PinToCode/Smart-Table-Assistant-/assests/IMG_6858.jpg

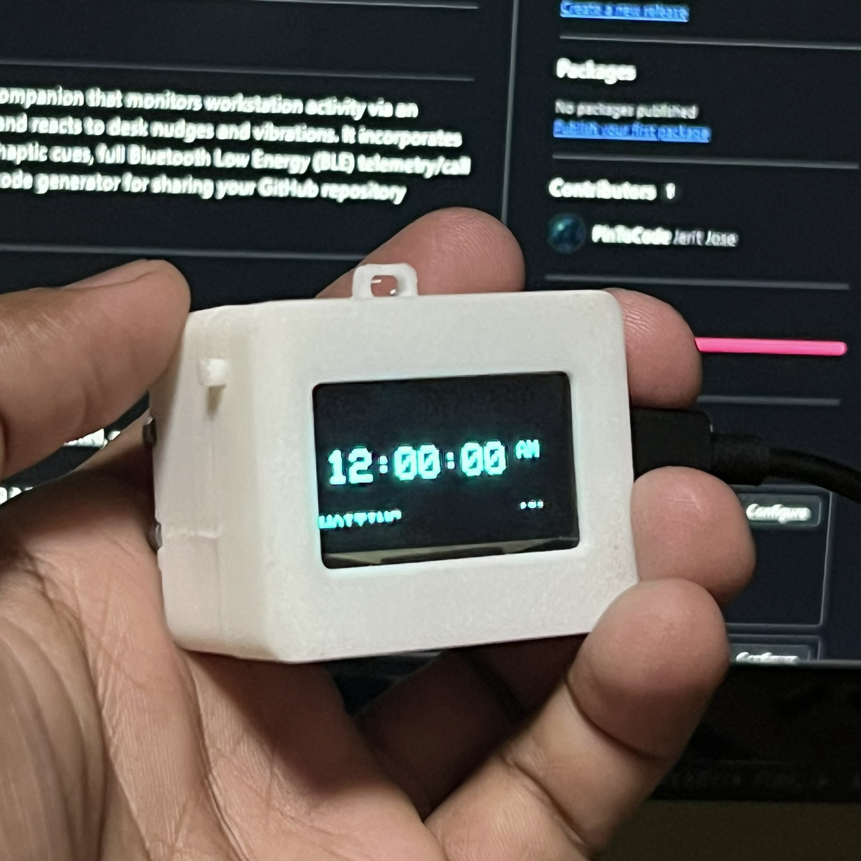
assests/IMG_6858.jpg
