PinToCode/Smart-Table-Assistant-/assests/IMG_6861.jpg

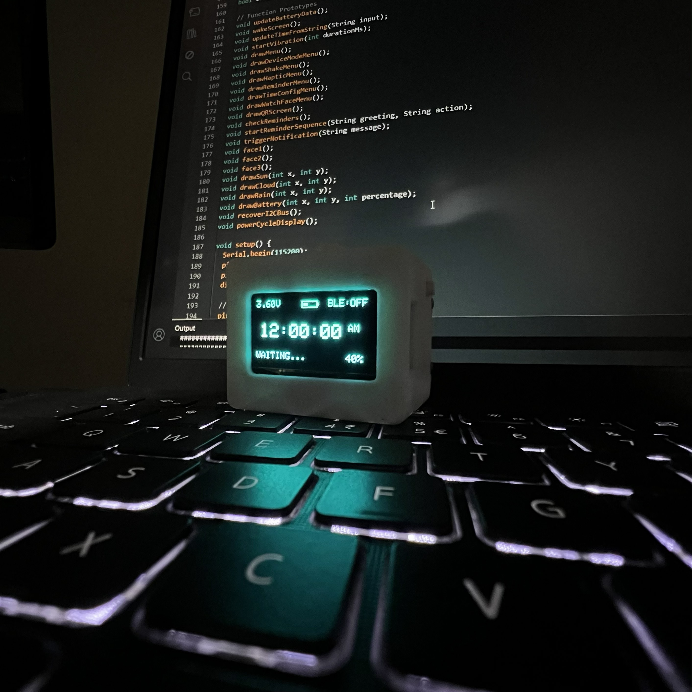
assests/IMG_6861.jpg
