PinToCode/Smart-Table-Assistant-/cad/cad files separatly/part2.stl

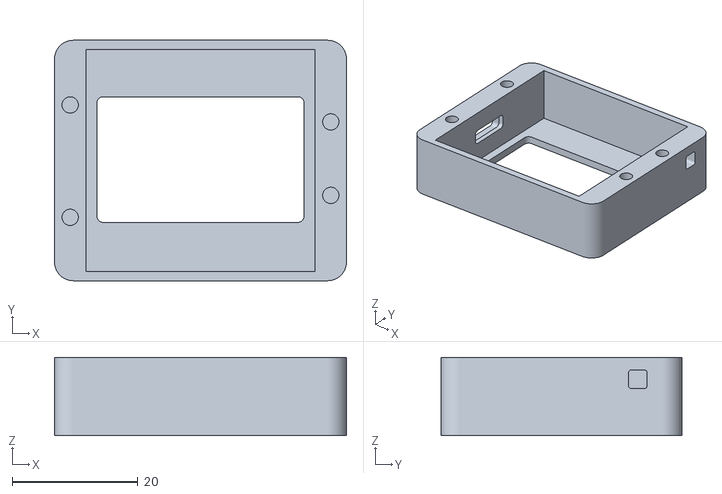
[picture p4: CAD file, 2026-10-28]
cad/cad files separatly/part2.stl
46.5 x 38.3 x 12.5
