PinToCode/Smart-Table-Assistant-/cad/smart table assistant.stl

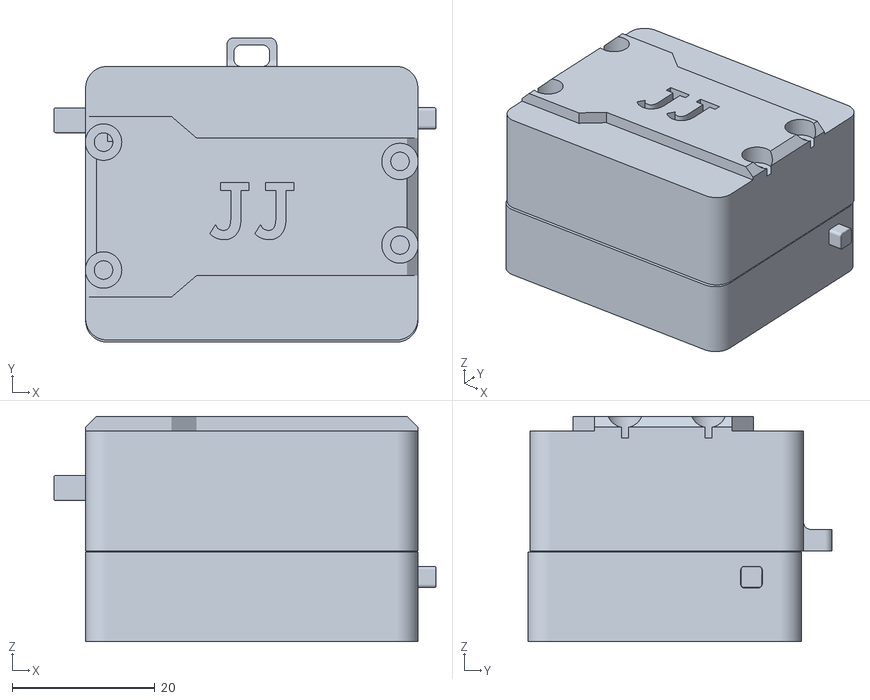
[picture p5: CAD file, 2026-10-28]
cad/smart table assistant.stl
53.5 x 42.6 x 31.5
