PinToCode/Smart-Table-Assistant-/cad/cad files separatly/part1.stl

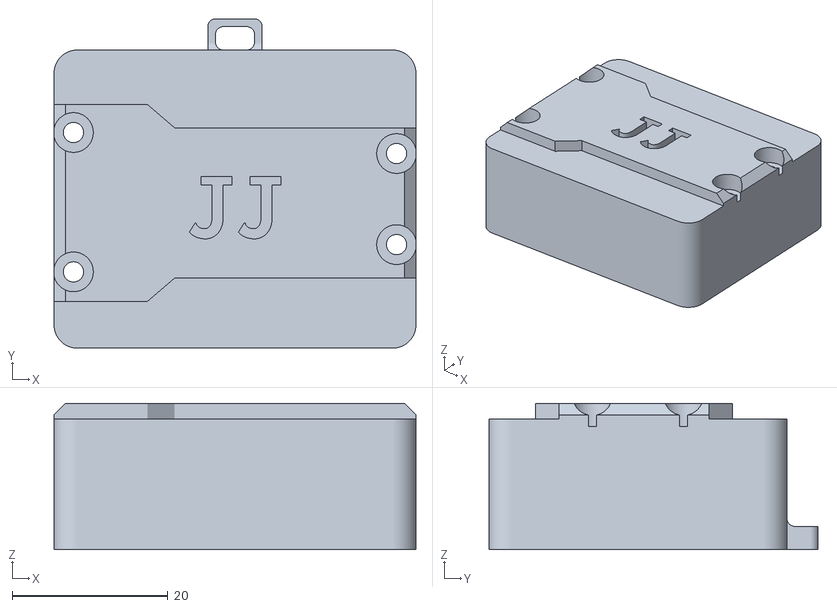
[picture p6: CAD file, 2026-10-28]
cad/cad files separatly/part1.stl
46.5 x 42.3 x 18.8
