PinToCode/Smart-Table-Assistant-/cad/cad files separatly/part4.stl

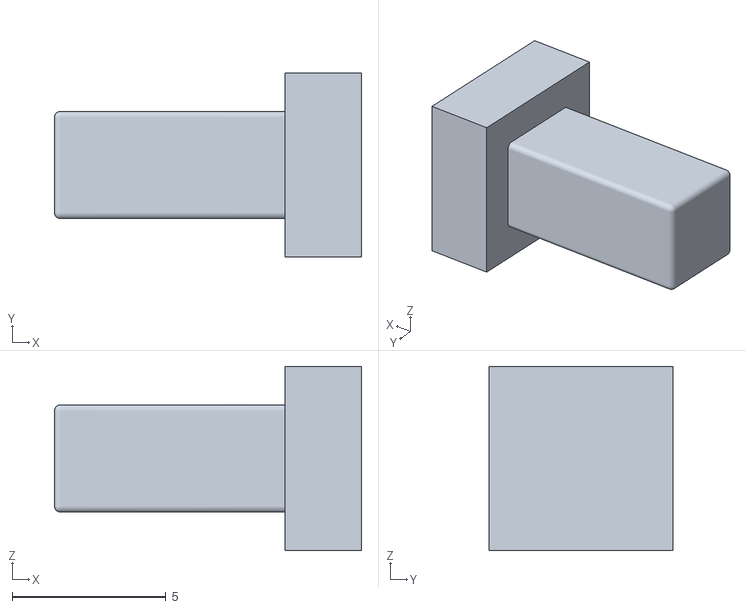
[picture p7: CAD file, 2026-10-28]
cad/cad files separatly/part4.stl
10.00 x 6.00 x 6.00
