PinToCode/Smart-Table-Assistant-/cad/cad files separatly/part3.stl

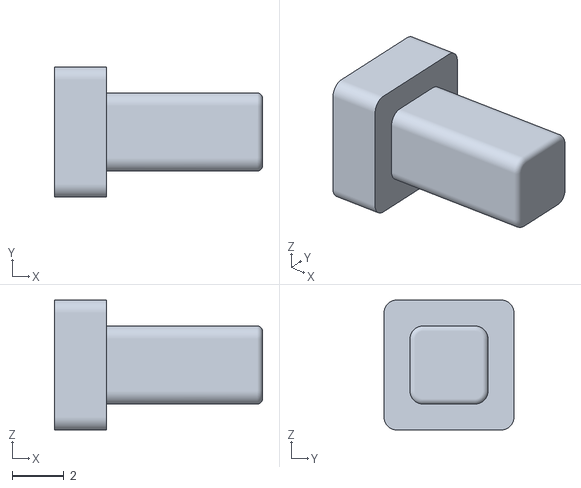
[picture p8: CAD file, 2026-10-28]
cad/cad files separatly/part3.stl
8.00 x 5.00 x 5.00
