PinToCode/Smart-Table-Assistant-/(notices)

Notices in the files:
readme.md:
License: MIT
